Ronit-R-P/Interactive-robot-hand/meshes/forearm.stl

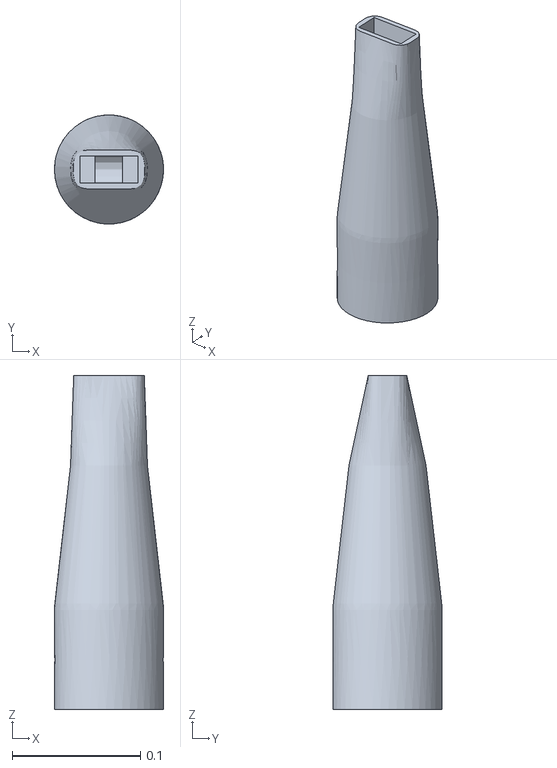
[picture p15: CAD file, 2026-09-30]
meshes/forearm.stl
0.085 x 0.085 x 0.26
