Ronit-R-P/Interactive-robot-hand/meshes/middle_proximal_phalanx.stl

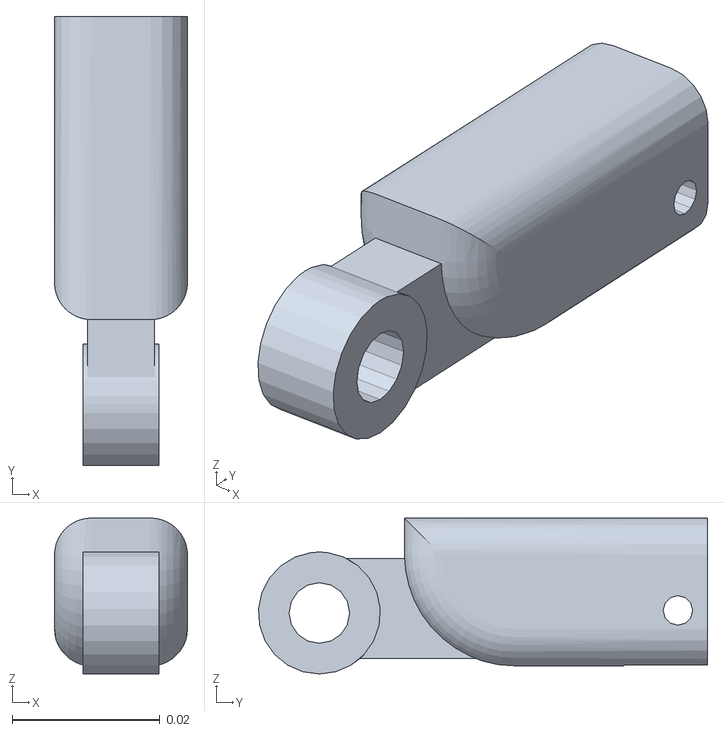
[picture p16: CAD file, 2026-09-30]
meshes/middle_proximal_phalanx.stl
0.018 x 0.0607 x 0.0211
