Ronit-R-P/Interactive-robot-hand/meshes/index_proximal_phalanx.stl

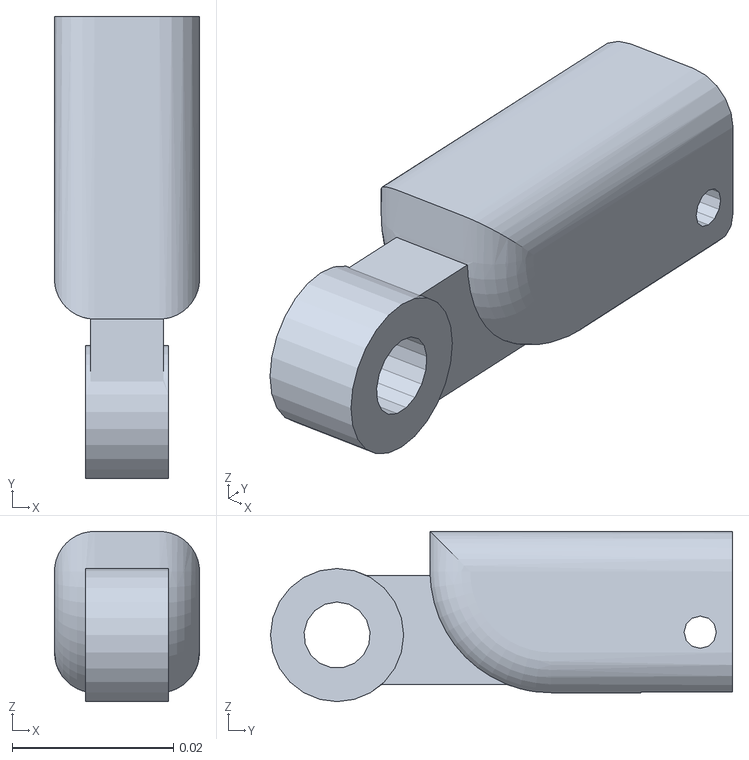
[picture p17: CAD file, 2026-09-30]
meshes/index_proximal_phalanx.stl
0.018 x 0.0572 x 0.0211
