Ronit-R-P/Interactive-robot-hand/meshes/ring_knuckle.stl

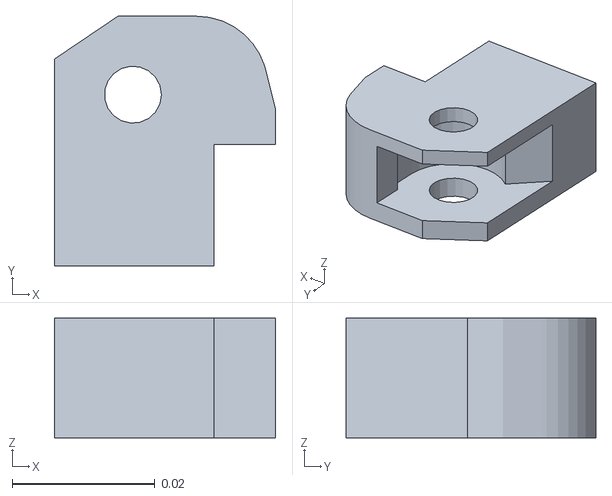
[picture p18: CAD file, 2026-09-30]
meshes/ring_knuckle.stl
0.031 x 0.035 x 0.0168
