Ronit-R-P/Interactive-robot-hand/meshes/pinky_proximal_phalanx.stl

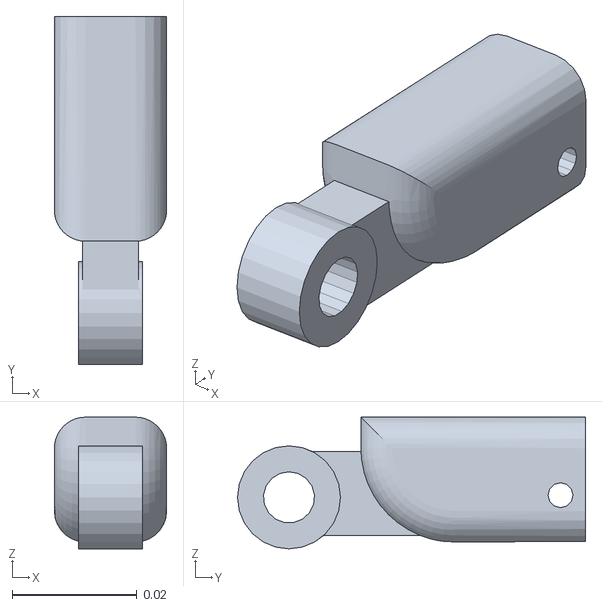
[picture p19: CAD file, 2026-09-30]
meshes/pinky_proximal_phalanx.stl
0.018 x 0.0558 x 0.0211
