Ronit-R-P/Interactive-robot-hand/meshes/thumb_proximal_phalanx.stl

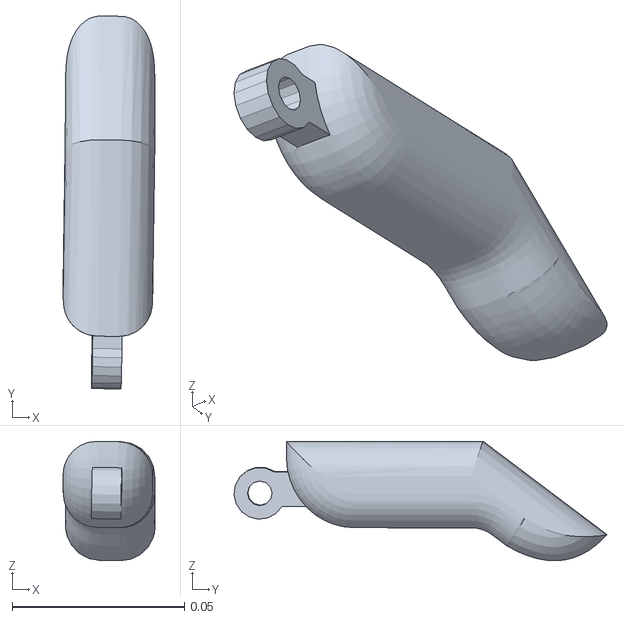
[picture p20: CAD file, 2026-09-30]
meshes/thumb_proximal_phalanx.stl
0.0266 x 0.108 x 0.0347
