Ronit-R-P/Interactive-robot-hand/meshes/palm.stl

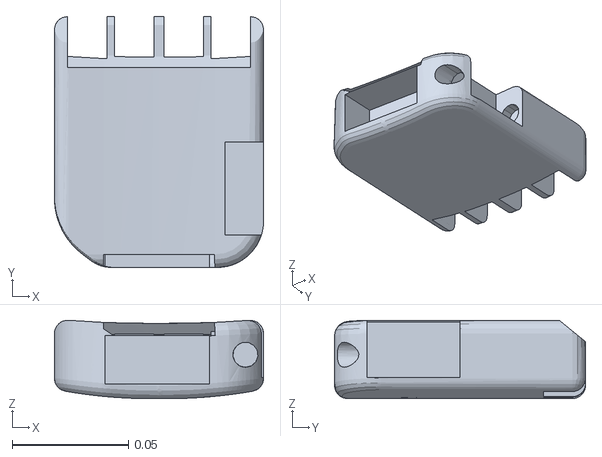
[picture p21: CAD file, 2026-09-30]
meshes/palm.stl
0.09 x 0.108 x 0.0337
