Ronit-R-P/Interactive-robot-hand/meshes/ring_middle_distal.stl

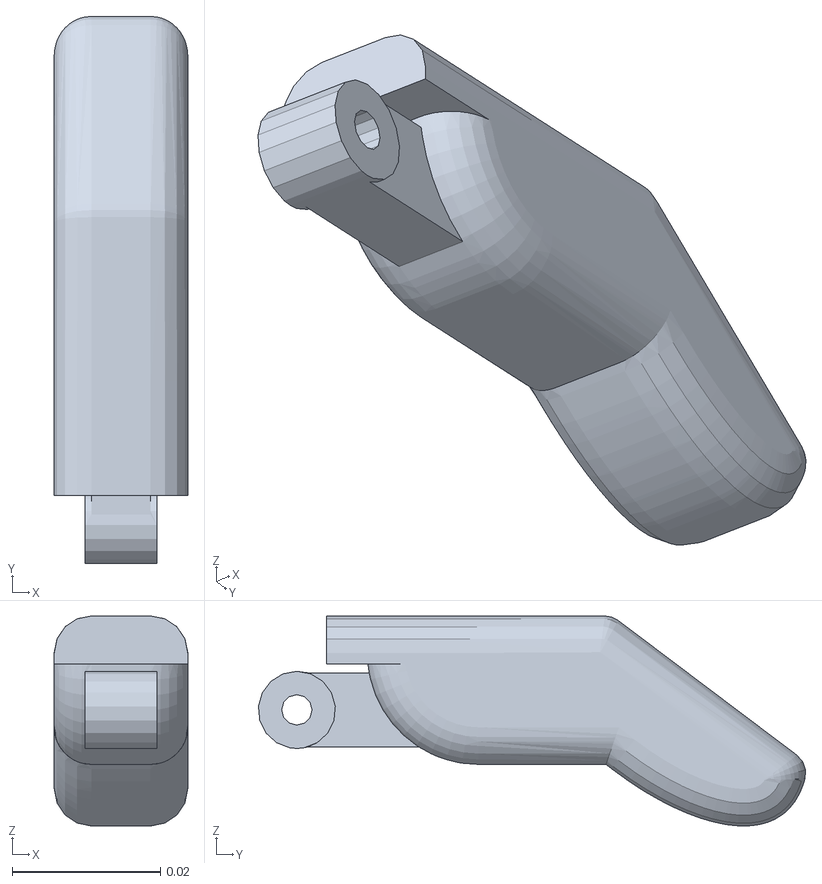
[picture p22: CAD file, 2026-09-30]
meshes/ring_middle_distal.stl
0.018 x 0.0737 x 0.0283
