Ronit-R-P/Interactive-robot-hand/meshes/middle_middle_distal.stl

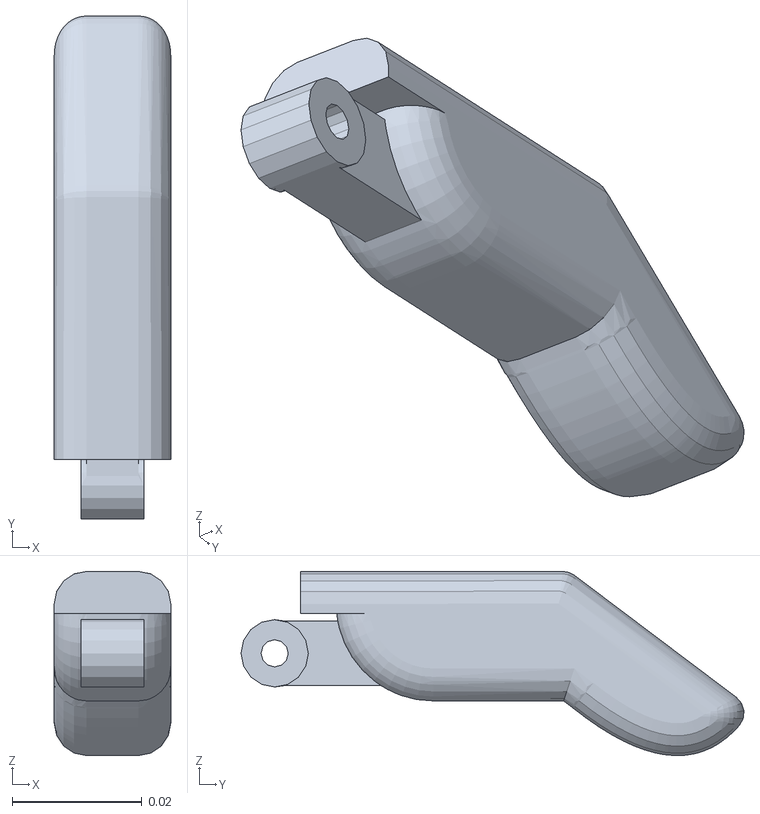
[picture p23: CAD file, 2026-09-30]
meshes/middle_middle_distal.stl
0.018 x 0.0777 x 0.0284
