Ronit-R-P/Interactive-robot-hand/meshes/pinky_midde_distal.stl

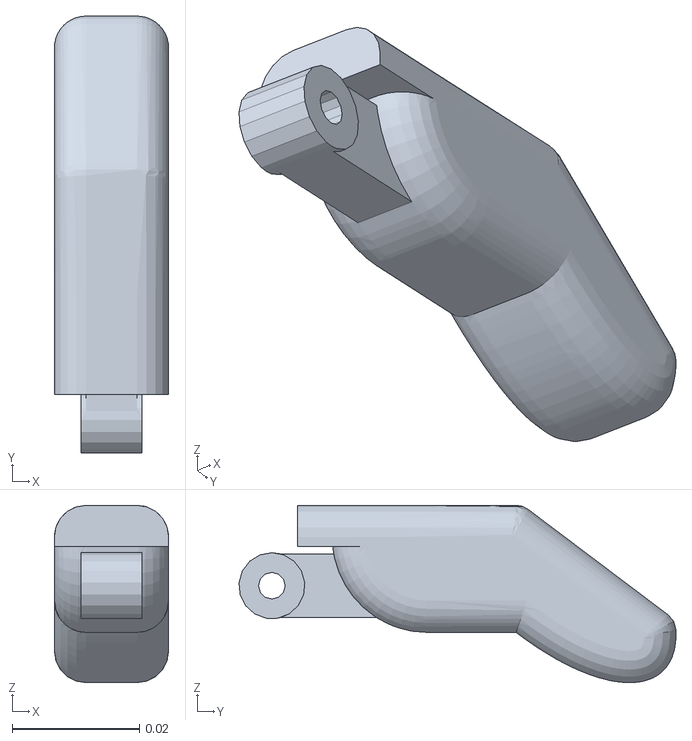
[picture p24: CAD file, 2026-09-30]
meshes/pinky_midde_distal.stl
0.018 x 0.0688 x 0.0279
