Ronit-R-P/Interactive-robot-hand/meshes/forearm_palm_connector.stl

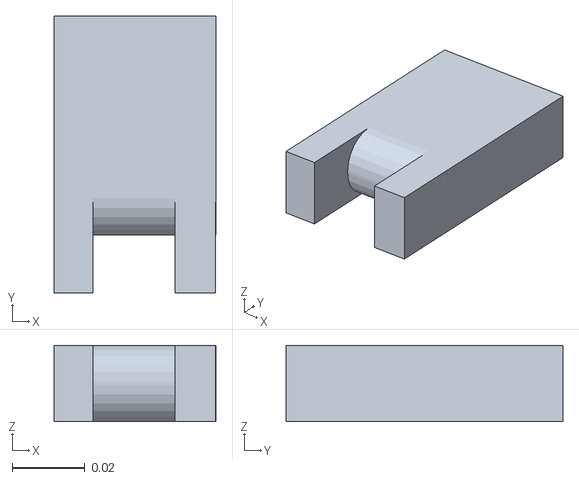
[picture p25: CAD file, 2026-09-30]
meshes/forearm_palm_connector.stl
0.0445 x 0.0763 x 0.021
