Ronit-R-P/Interactive-robot-hand/meshes/thumb_rotating_knuckle.stl

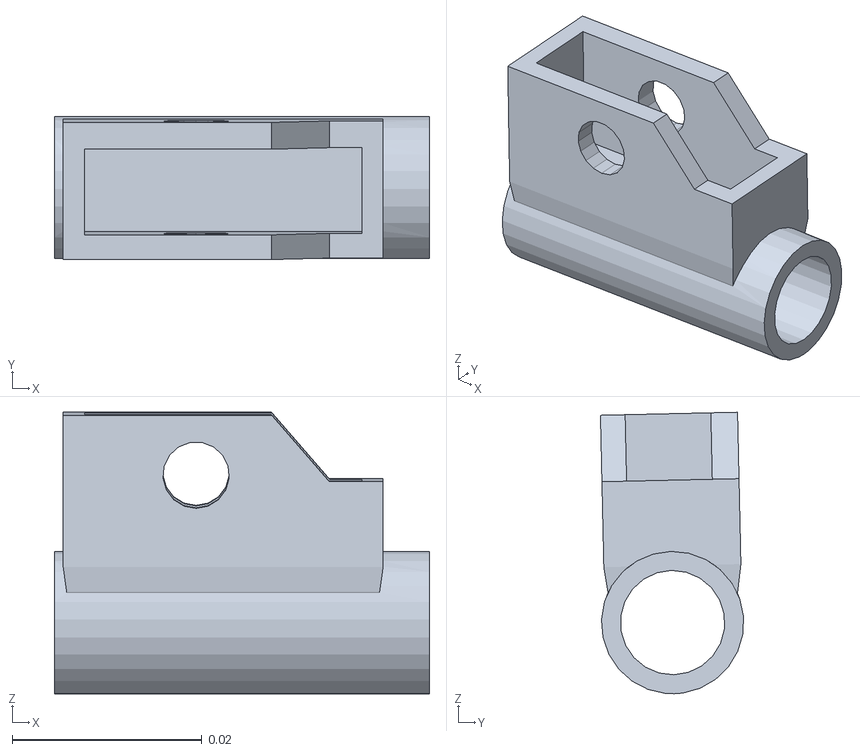
[picture p26: CAD file, 2026-09-30]
meshes/thumb_rotating_knuckle.stl
0.0395 x 0.0151 x 0.0297
