Ronit-R-P/Interactive-robot-hand/(list of files, cad)

Other CAD files:
meshes/index_middle_distal_phalanx.stl
meshes/ring_proximal_phalanx.stl
