Ronit-R-P/Interactive-robot-hand/(commit log)

2026-10-27 Implement stage tracking for loading process
    Added performance tracking and stage management for loading.
2026-10-27 Add loading stages for MuJoCo and XML assets
